ErickGiffoni/balanca_aerodinamica/(threads)

Thread 1 (2019-05-05):

Ler os dados da célula de carga, via Arduino

ErickGiffoni, 2019-05-05:
Precisa-se ler os dados da célula de carga, via Arduino, para que possam ser realizados os cálculos necessários, posteriormente.

### Tasks
- [ ] Saber qual a função do Arduino para ler os dados
- [ ]  Guardar os dados lidos de alguma maneira

Thread 2 (2019-05-05):

Links úteis para o projeto

ErickGiffoni, 2019-05-05:
Aqui devem ser adicionados links úteis para o projeto.

ErickGiffoni, 2019-05-05:
Arduino reference : [https://www.arduino.cc/reference/en/](url)

MoacirMSJ, 2019-05-05:
Balança digital com Arduíno e células de carga :http://blog.eletrogate.com/balanca-digital-com-arduino-aprenda-a-usar-a-celula-de-carga/

ErickGiffoni, 2019-06-14:
testando comentario
