ErickGiffoni/balanca_aerodinamica/(commit log)

2019-05-20 Criacao do algoritmo de calibragem.
2019-05-20 Iniciado algoritmo de calibragem.
2019-05-22 Atualizado algoritmo de calibracao.
2019-05-24 "Corrigido erros de escrita e atualizada as funcoes."
2019-06-16 #4 Funcoes de calculo para serem utilizadas no codigo principal
2019-06-17 update balanca_aero.ino update calculations add correction factor to air density
    [balanca_aero.ino]
2019-07-03 Corrigido prints.
2019-07-03 Adicionado prints das forças.
